hallgchris/mail-to-telegram/README.md

# Mail to Telegram

Idea: Reed switch detects mail entering letterbox. Notify family group chat via Telegram.

Result: Excuse to make a PCB and fiddle with the ESP32 module.

> 🎶 *We just got a letter, we just got a letter...*
