hallgchris/mail-to-telegram/cad/mail-to-telegram-Lid.stl

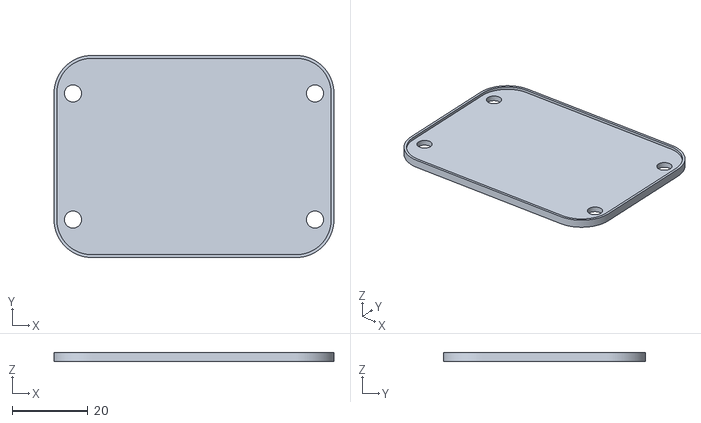
[picture p1: CAD file, 2021-06-18]
cad/mail-to-telegram-Lid.stl
73.7 x 53.2 x 2.40
