hallgchris/mail-to-telegram/cad/mail-to-telegram.FCStd

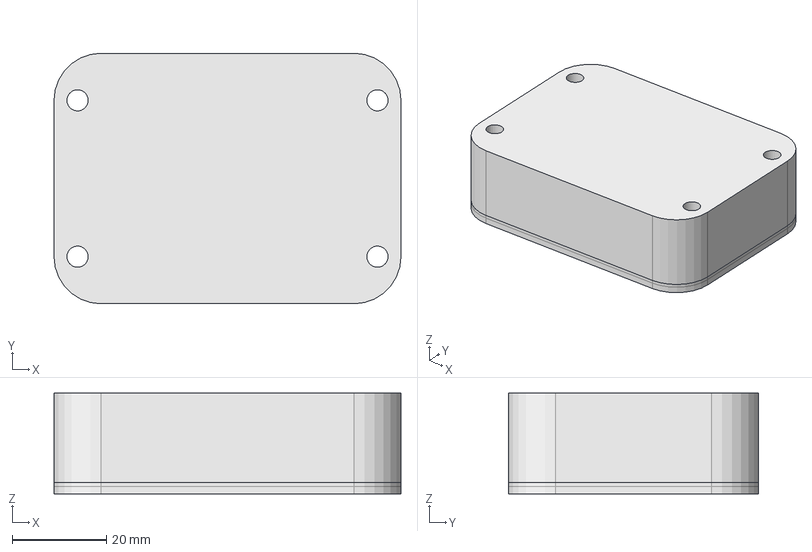
[picture p2: CAD file, 2021-06-18]
cad/mail-to-telegram.FCStd
73.7 x 53.2 x 21.4 mm
Pcb_e0a5
topTracks_e0a5
R3_R_0603_1608Metric_60BE3A8B x 5
pines
cuerpo
boton
C6_C_0603_1608Metric_60BE39BC x 6
U1_SOT_23_5_60BDE8CE
U2_ESP32-WROOM-32_60BDC9C3
D1_D_0603_60BE43DD
BT1_Keystone_2479_3xAAA_60BE3ADF
J2_PinHeader_1x04_P254mm_Vertical_60BE024C
J1_PinHeader_1x05_P254mm_Vertical_60BE46CC
J3_TerminalBlock_Phoenix_PT_15_3_35_H_1x03_P350mm_Horizontal_60BDC8CF
Enclosure
Lid
