hallgchris/mail-to-telegram/cad/mail-to-telegram-Enclosure.stl

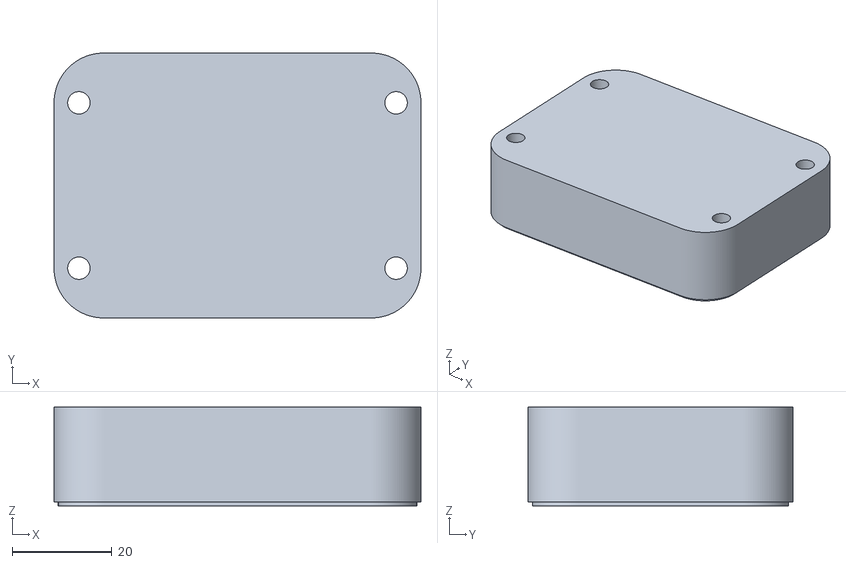
[picture p3: CAD file, 2021-06-18]
cad/mail-to-telegram-Enclosure.stl
73.7 x 53.2 x 19.8
