hallgchris/mail-to-telegram/pcb/mail-to-telegram.kicad_pcb

## KiCad design pcb/mail-to-telegram.kicad_pcb (2021-06-09)

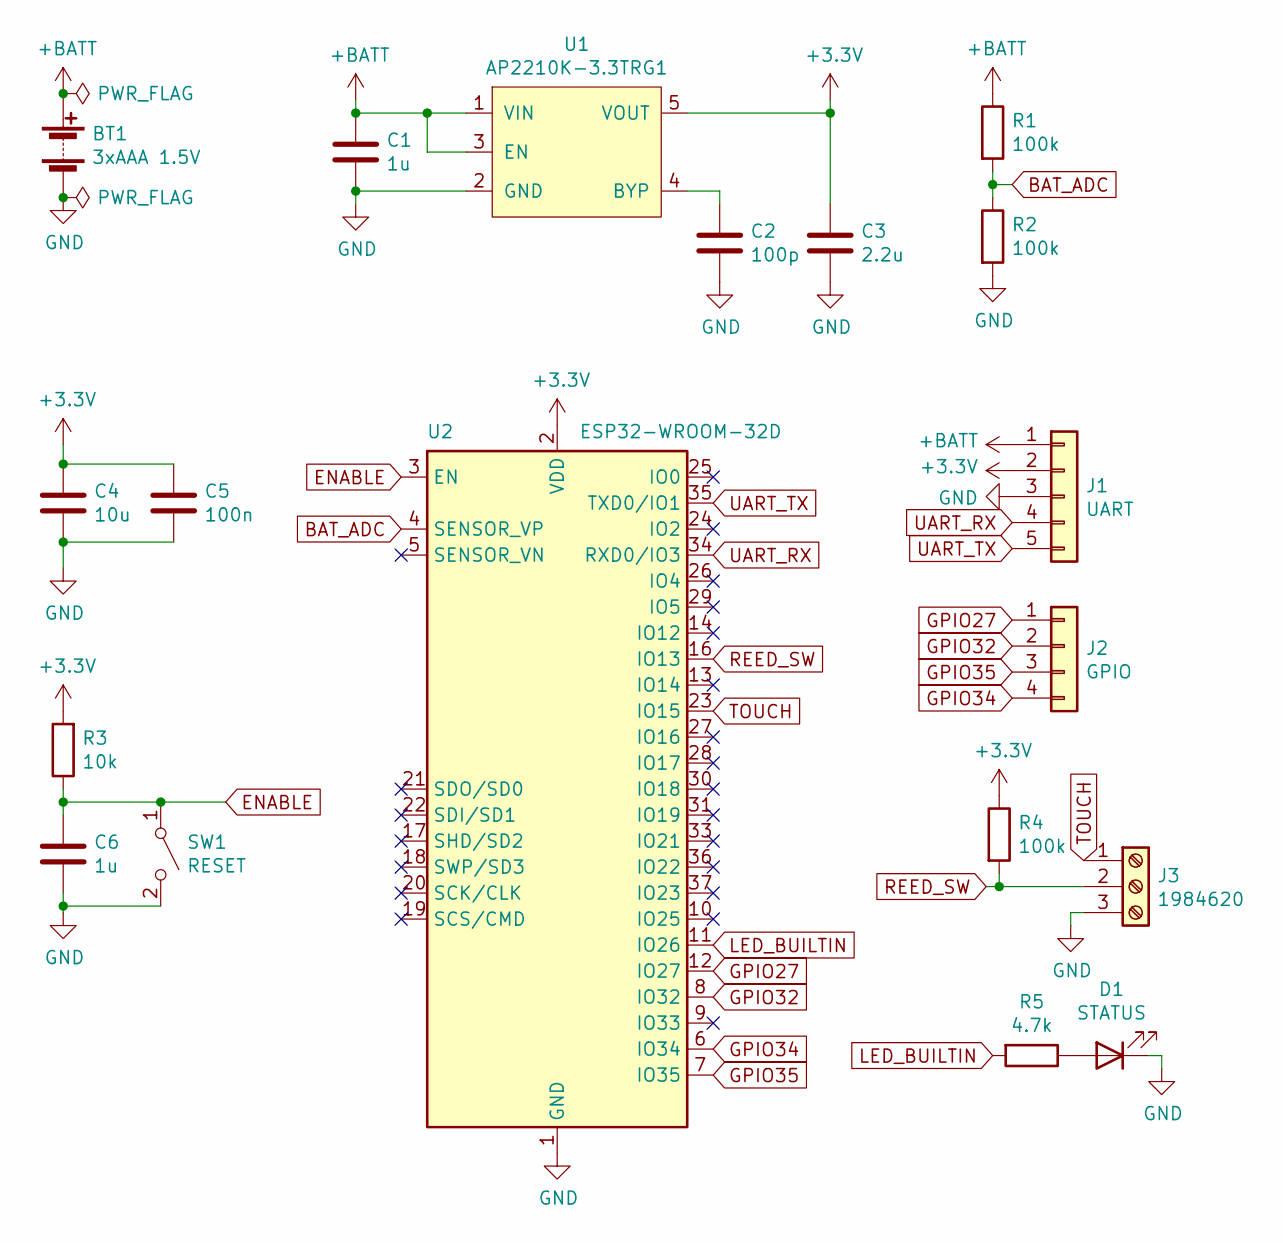
[picture p4: schematic mail-to-telegram.sch]

Parts:
BT1: 3xAAA 1.5V; BatteryHolder_Keystone_2479_3xAAA
C1, C6: 1u; C_0603_1608Metric_Pad1.08x0.95mm_HandSolder
C2: 100p; C_0603_1608Metric_Pad1.08x0.95mm_HandSolder
C3: 2.2u; C_0603_1608Metric_Pad1.08x0.95mm_HandSolder
C4: 10u; C_0603_1608Metric_Pad1.08x0.95mm_HandSolder
C5: 100n; C_0603_1608Metric_Pad1.08x0.95mm_HandSolder
D1: STATUS; D_0603_1608Metric_Pad1.05x0.95mm_HandSolder
J1: UART; PinHeader_1x05_P2.54mm_Vertical
J2: GPIO; PinHeader_1x04_P2.54mm_Vertical
J3: 1984620; TerminalBlock_Phoenix_PT-1,5-3-3.5-H_1x03_P3.50mm_Horizontal
R1, R2, R4: 100k; R_0603_1608Metric_Pad0.98x0.95mm_HandSolder
R3: 10k; R_0603_1608Metric_Pad0.98x0.95mm_HandSolder
R5: 4.7k; R_0603_1608Metric_Pad0.98x0.95mm_HandSolder
SW1: RESET; SW_SPST_FSMSM
U1: AP2210K-3.3TRG1; SOT-23-5
U2: ESP32-WROOM-32D; ESP32-WROOM-32

Connections:
+3V3: C3.1, C4.1, C5.1, J1.2, R3.2, R4.1, U1.5 (VOUT), U2.2 (VDD)
+BATT: BT1.1 (+), C1.1, J1.1, R1.1, U1.1 (VIN), U1.3 (EN)
BAT_ADC: R1.2, R2.1, U2.4 (SENSOR_VP)
ENABLE: C6.1, R3.1, SW1.1 (A), U2.3 (EN)
GND: BT1.2 (-), C1.2, C2.2, C3.2, C4.2, C5.2, C6.2, D1.1 (K), J1.3, J3.3, R2.2, SW1.2 (B), U1.2 (GND), U2.1 (GND), U2.15 (GND), U2.38 (GND), U2.39 (GND)
GPIO27: J2.1, U2.12 (IO27)
GPIO32: J2.2, U2.8 (IO32)
GPIO34: J2.4, U2.6 (IO34)
GPIO35: J2.3, U2.7 (IO35)
LED_BUILTIN: R5.2, U2.11 (IO26)
unnamed: C2.1, U1.4 (BYP)
unnamed: D1.2 (A), R5.1
REED_SW: J3.2, R4.2, U2.16 (IO13)
TOUCH: J3.1, U2.23 (IO15)
UART_RX: J1.4, U2.34 (RXD0/IO3)
UART_TX: J1.5, U2.35 (TXD0/IO1)

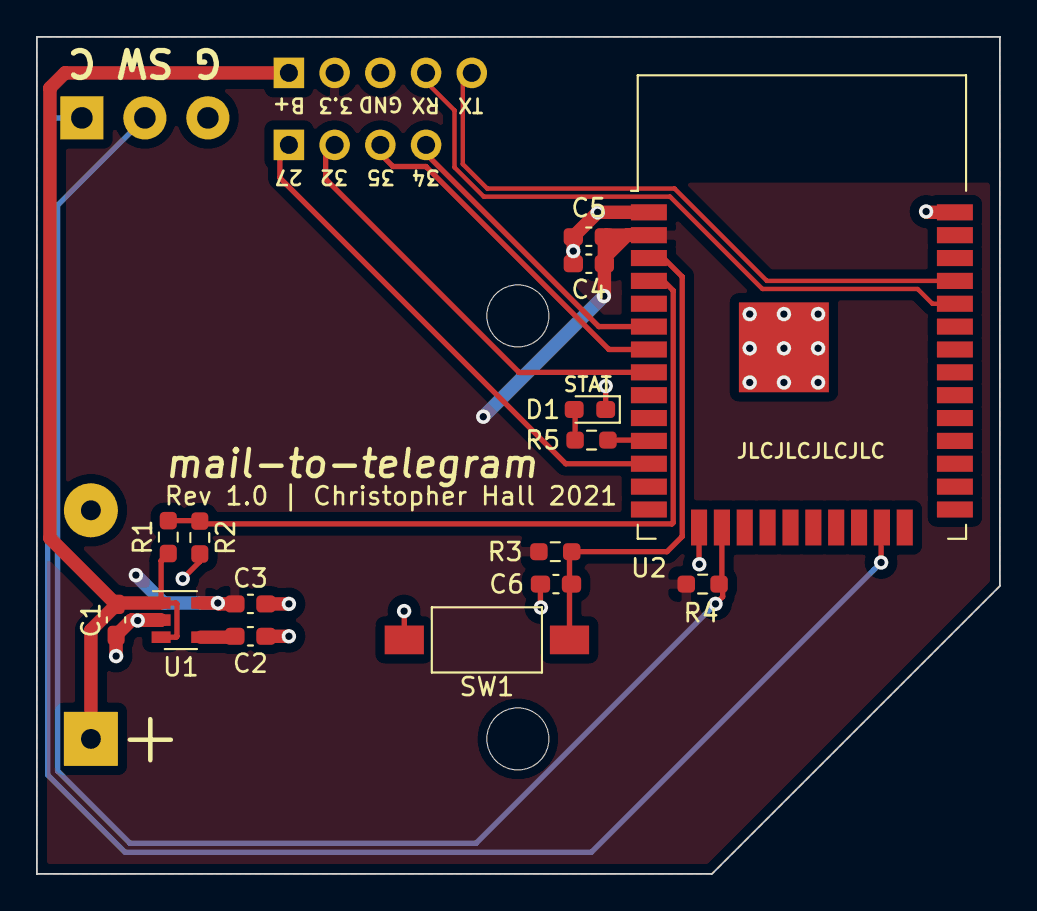
[picture p5: board mail-to-telegram.kicad_pcb from above]

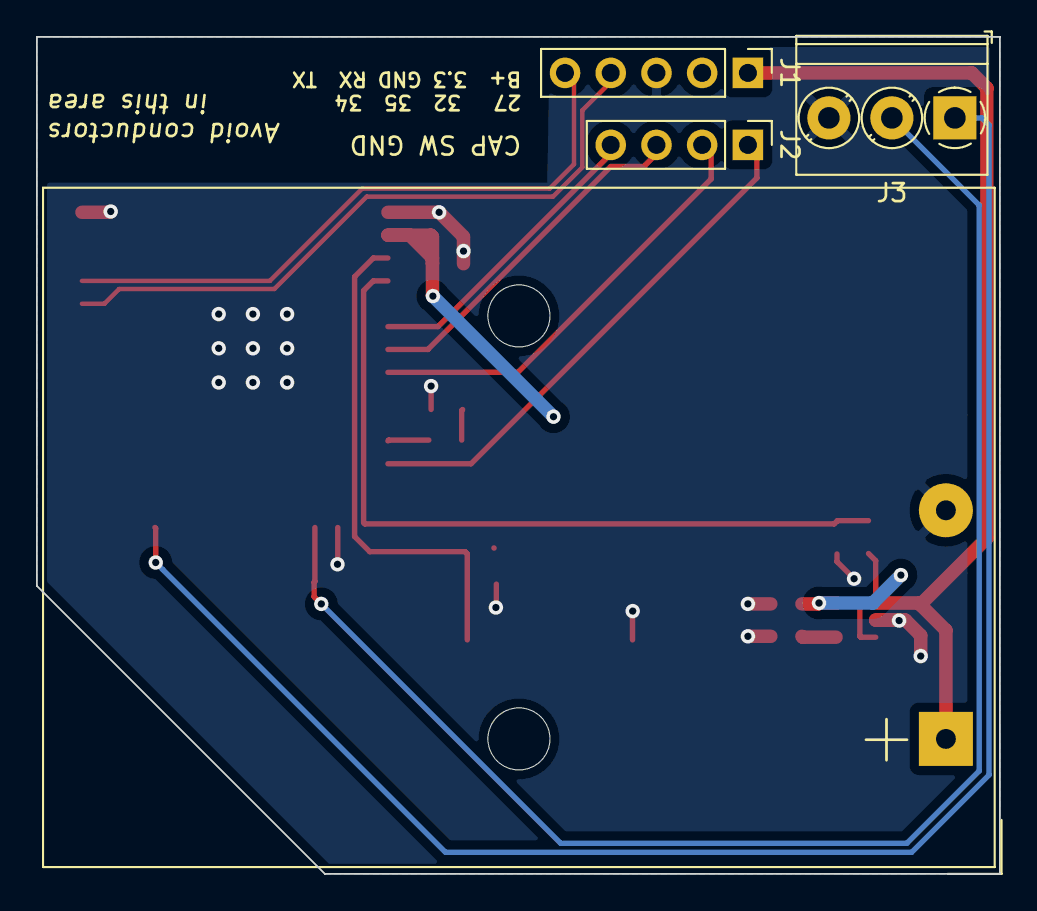
[picture p6: board mail-to-telegram.kicad_pcb from below]

Board: 2 copper layers, 53.5 x 46.5 mm, 19 parts (4 on the bottom side), 16 nets.
