hallgchris/mail-to-telegram/(commit log)

2021-06-09 pcb: Add v1.0 PCB (no git history whoops)
    [mail-to-telegram-B_Cu.gbr, mail-to-telegram-B_Mask.gbr, mail-to-telegram-B_Paste.gbr, mail-to-telegram-B_SilkS.gbr, mail-to-telegram-Edge_Cuts.gbr, mail-to-telegram-F_Cu.gbr, mail-to-telegram-F_Mask.gbr, mail-to-telegram-F_Paste.gbr]
2021-06-10 fw: Deep sleep while waiting for reed switch trigger
2021-06-11 fw: Read and send battery voltage
2021-06-18 fw: Update pins for PCB (previously for dev board)
2021-06-18 fw: Don't send multiple notifications if switch is held open
2021-06-18 cad: Add initial enclosure design
    [mail-to-telegram-Enclosure.stl, mail-to-telegram-Lid.stl, mail-to-telegram.FCStd]
